ekiwi/iuhr/drawings/4digit.dxf

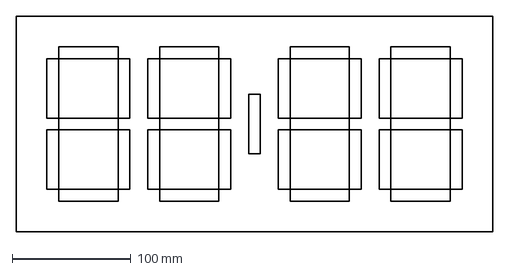
[picture p1: CAD file, 2013-12-15]
drawings/4digit.dxf
402.0 x 182.0 mm
