ekiwi/iuhr/drawings/5digit.dxf

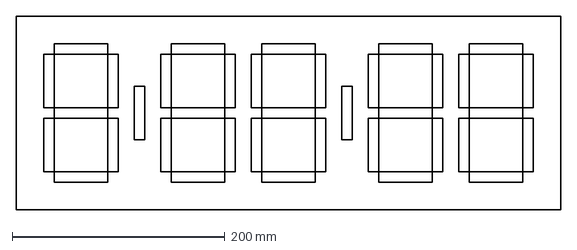
[picture p2: CAD file, 2013-12-15]
drawings/5digit.dxf
512.0 x 182.0 mm
