ekiwi/iuhr/pcbs/iuhr.brd

## EAGLE design pcbs/iuhr.brd (2014-12-14)

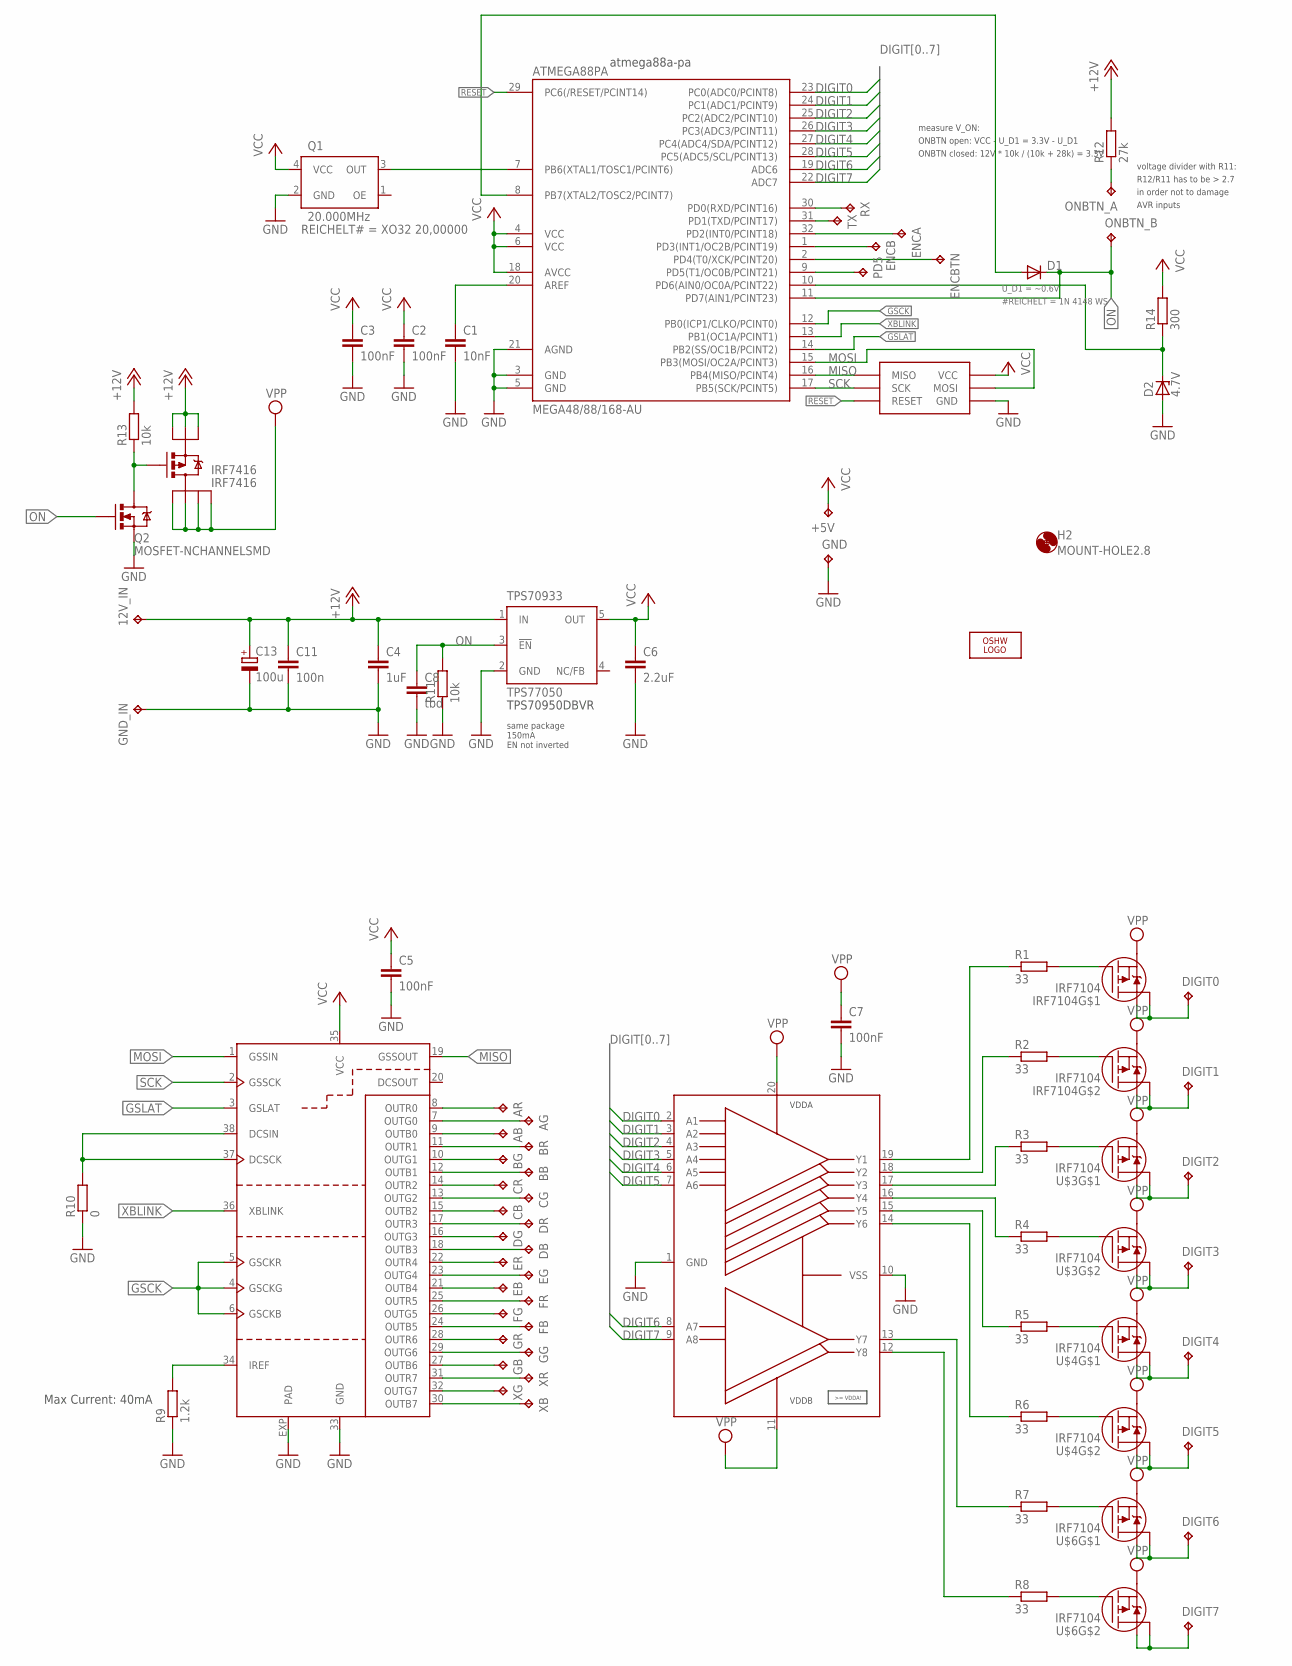
[picture p3: schematic iuhr.sch]

Parts:
12V_IN: TPTP20SQ; TP20SQ
+5V: TPTP15SQ; TP15SQ
AB: TPTP15SQ; TP15SQ
ADG3123: ADG3123BRUZ; TSSOP20
AG: TPTP15SQ; TP15SQ
AR: TPTP15SQ; TP15SQ
ATMEGA88PA: MEGA48/88/168-AU; TQFP32-08
BB: TPTP15SQ; TP15SQ
BG: TPTP15SQ; TP15SQ
BR: TPTP15SQ; TP15SQ
C1: 10nF; C0603
C2, C3, C5, C7: 100nF; C0603
C4: 1uF; C0805
C6: 2.2uF; C0805
C8: tbd; C0603
C11: 100n; C0603
C13: 100u; PANASONIC_E
CB: TPTP15SQ; TP15SQ
CG: TPTP15SQ; TP15SQ
CR: TPTP15SQ; TP15SQ
D1: DIODE-SOD323-R; SOD323-R
D2: 4.7V; SOT23
DB: TPTP15SQ; TP15SQ
DG: TPTP15SQ; TP15SQ
DIGIT0, DIGIT1, DIGIT2, DIGIT3, DIGIT4, DIGIT5, DIGIT6, DIGIT7: TPTP20SQ; TP20SQ
DR: TPTP15SQ; TP15SQ
EB: TPTP15SQ; TP15SQ
EG: TPTP15SQ; TP15SQ
ENCA: TPTP15SQ; TP15SQ
ENCB: TPTP15SQ; TP15SQ
ENCBTN: TPTP15SQ; TP15SQ
ER: TPTP15SQ; TP15SQ
FB: TPTP15SQ; TP15SQ
FG: TPTP15SQ; TP15SQ
FR: TPTP15SQ; TP15SQ
GB: TPTP15SQ; TP15SQ
GG: TPTP15SQ; TP15SQ
GND: TPTP15SQ; TP15SQ
GND_IN: TPTP20SQ; TP20SQ
GR: TPTP15SQ; TP15SQ
H2: MOUNT-HOLE2.8; 2,8
IRF7104: IRF7104; SO8-2
IRF7416: IRF7416; SO8-2
LOGO1: OSHW_LOGO_8MILX0200-NT; OSHW_8X200_NOTEXT
ONBTN_A: TPTP15SQ; TP15SQ
ONBTN_B: TPTP15SQ; TP15SQ
PD5: TPTP15SQ; TP15SQ
Q1: 20.000MHz; XO32
Q2: MOSFET-NCHANNELSMD; SOT23-3
R1, R2, R3, R4, R5, R6, R7, R8: 33; R0603
R9: 1.2k; R0603
R10: 0; R0603
R11, R13: 10k; R0603
R12: 27k; R0603
R14: 300; R0603
RX: TPTP15SQ; TP15SQ
TLC5951: TLC5951; HTSSOP38DAP
TPS70933: TPS77050; SOT23-DBV
TX: TPTP15SQ; TP15SQ
U$3, U$4, U$6: IRF7104; SO8-2
U$5: ISP_SPECIALS; ISP_RM2_00_STRAIGHT
XB: TPTP15SQ; TP15SQ
XG: TPTP15SQ; TP15SQ
XR: TPTP15SQ; TP15SQ

Connections:
+12V: 12V_IN.TP, C4.1, C11.1, C13.+, IRF7416.1 (S), IRF7416.2 (S1), IRF7416.3 (S2), R12.2, R13.2, TPS70933.1 (IN)
CLK_STM: ATMEGA88PA.7 (PB6(XTAL1/TOSC1/PCINT6)), Q1.3 (OUT)
DIGIT0: ADG3123.2 (A1), ATMEGA88PA.23 (PC0(ADC0/PCINT8))
DIGIT1: ADG3123.3 (A2), ATMEGA88PA.24 (PC1(ADC1/PCINT9))
DIGIT2: ADG3123.4 (A3), ATMEGA88PA.25 (PC2(ADC2/PCINT10))
DIGIT3: ADG3123.5 (A4), ATMEGA88PA.26 (PC3(ADC3/PCINT11))
DIGIT4: ADG3123.6 (A5), ATMEGA88PA.27 (PC4(ADC4/SDA/PCINT12))
DIGIT5: ADG3123.7 (A6), ATMEGA88PA.28 (PC5(ADC5/SCL/PCINT13))
DIGIT6: ADG3123.8 (A7), ATMEGA88PA.19 (ADC6)
DIGIT7: ADG3123.9 (A8), ATMEGA88PA.22 (ADC7)
GND: ADG3123.1 (GND), ADG3123.10 (VSS), ATMEGA88PA.3 (GND), ATMEGA88PA.5 (GND), ATMEGA88PA.21 (AGND), C1.2, C2.2, C3.2, C4.2, C5.2, C6.2, C7.2, C8.2, C11.2, C13.-, D2.1 (A), GND.TP, GND_IN.TP, Q1.2 (GND), Q2.2 (S), R9.1, R10.1, R11.1, TLC5951.33 (GND), TLC5951.EXP (PAD), TPS70933.2 (GND), U$5.VCC (GND)
GSCK: ATMEGA88PA.12 (PB0(ICP1/CLKO/PCINT0)), TLC5951.4 (GSCKG), TLC5951.5 (GSCKR), TLC5951.6 (GSCKB)
GSLAT: ATMEGA88PA.14 (PB2(SS/OC1B/PCINT2)), TLC5951.3 (GSLAT)
MISO: ATMEGA88PA.16 (PB4(MISO/PCINT4)), TLC5951.19 (GSSOUT), U$5.RESET (MISO)
MOSI: ATMEGA88PA.15 (PB3(MOSI/OC2A/PCINT3)), TLC5951.1 (GSSIN), U$5.MOSI
unnamed: AR.TP, TLC5951.8 (OUTR0)
unnamed: ATMEGA88PA.20 (AREF), C1.1
unnamed: AG.TP, TLC5951.7 (OUTG0)
unnamed: AB.TP, TLC5951.9 (OUTB0)
unnamed: BR.TP, TLC5951.11 (OUTR1)
unnamed: BG.TP, TLC5951.10 (OUTG1)
unnamed: ATMEGA88PA.30 (PD0(RXD/PCINT16)), RX.TP
unnamed: BB.TP, TLC5951.12 (OUTB1)
unnamed: CR.TP, TLC5951.14 (OUTR2)
unnamed: CG.TP, TLC5951.13 (OUTG2)
unnamed: CB.TP, TLC5951.15 (OUTB2)
unnamed: ATMEGA88PA.31 (PD1(TXD/PCINT17)), TX.TP
unnamed: DR.TP, TLC5951.17 (OUTR3)
unnamed: DG.TP, TLC5951.16 (OUTG3)
unnamed: DB.TP, TLC5951.18 (OUTB3)
unnamed: ER.TP, TLC5951.22 (OUTR4)
unnamed: EG.TP, TLC5951.23 (OUTG4)
unnamed: EB.TP, TLC5951.21 (OUTB4)
unnamed: FR.TP, TLC5951.25 (OUTR5)
unnamed: FG.TP, TLC5951.26 (OUTG5)
unnamed: ATMEGA88PA.32 (PD2(INT0/PCINT18)), ENCA.TP
unnamed: FB.TP, TLC5951.24 (OUTB5)
unnamed: GR.TP, TLC5951.28 (OUTR6)
unnamed: GG.TP, TLC5951.29 (OUTG6)
unnamed: GB.TP, TLC5951.27 (OUTB6)
unnamed: TLC5951.31 (OUTR7), XR.TP
unnamed: TLC5951.32 (OUTG7), XG.TP
unnamed: TLC5951.30 (OUTB7), XB.TP
unnamed: DIGIT0.TP, IRF7104.7 (D), IRF7104.8 (D)
unnamed: DIGIT1.TP, IRF7104.5 (D), IRF7104.6 (D)
unnamed: IRF7104.2 (G), R1.2
unnamed: IRF7104.4 (G), R2.2
unnamed: ADG3123.19 (Y1), R1.1
unnamed: DIGIT6.TP, U$6.7 (D), U$6.8 (D)
unnamed: DIGIT2.TP, U$3.7 (D), U$3.8 (D)
unnamed: DIGIT3.TP, U$3.5 (D), U$3.6 (D)
unnamed: R3.2, U$3.2 (G)
unnamed: R4.2, U$3.4 (G)
unnamed: ADG3123.17 (Y3), R3.1
unnamed: ADG3123.16 (Y4), R4.1
unnamed: DIGIT4.TP, U$4.7 (D), U$4.8 (D)
unnamed: DIGIT5.TP, U$4.5 (D), U$4.6 (D)
unnamed: R5.2, U$4.2 (G)
unnamed: R6.2, U$4.4 (G)
unnamed: ADG3123.15 (Y5), R5.1
unnamed: ADG3123.14 (Y6), R6.1
unnamed: ADG3123.18 (Y2), R2.1
unnamed: DIGIT7.TP, U$6.5 (D), U$6.6 (D)
unnamed: R7.2, U$6.2 (G)
unnamed: R8.2, U$6.4 (G)
unnamed: ADG3123.13 (Y7), R7.1
unnamed: ADG3123.12 (Y8), R8.1
unnamed: ATMEGA88PA.1 (PD3(INT1/OC2B/PCINT19)), ENCB.TP
unnamed: ATMEGA88PA.2 (PD4(T0/XCK/PCINT20)), ENCBTN.TP
unnamed: R9.2, TLC5951.34 (IREF)
unnamed: ATMEGA88PA.9 (PD5(T1/OC0B/PCINT21)), PD5.TP
unnamed: ATMEGA88PA.10 (PD6(AIN0/OC0A/PCINT22)), D2.3 (C), R14.1
unnamed: ATMEGA88PA.8 (PB7(XTAL2/TOSC2/PCINT7)), D1.A
unnamed: ONBTN_A.TP, R12.1
unnamed: R10.2, TLC5951.37 (DCSCK), TLC5951.38 (DCSIN)
unnamed: IRF7416.4 (G), Q2.3 (D), R13.1
ON: ATMEGA88PA.11 (PD7(AIN1/PCINT23)), C8.1, D1.C, ONBTN_B.TP, Q2.1 (G), R11.2, TPS70933.3 (!EN)
RESET: ATMEGA88PA.29 (PC6(/RESET/PCINT14)), U$5.MISO (RESET)
SCK: ATMEGA88PA.17 (PB5(SCK/PCINT5)), TLC5951.2 (GSSCK), U$5.SCK
VCC: +5V.TP, ATMEGA88PA.4 (VCC), ATMEGA88PA.6 (VCC), ATMEGA88PA.18 (AVCC), C2.1, C3.1, C5.1, C6.1, Q1.4 (VCC), R14.2, TLC5951.35 (VCC), TPS70933.5 (OUT), U$5.GND (VCC)
VPP: ADG3123.11 (VDDB), ADG3123.20 (VDDA), C7.1, IRF7104.1 (S), IRF7104.3 (S), IRF7416.5 (D3), IRF7416.6 (D2), IRF7416.7 (D1), IRF7416.8 (D), U$3.1 (S), U$3.3 (S), U$4.1 (S), U$4.3 (S), U$6.1 (S), U$6.3 (S)
XBLINK: ATMEGA88PA.13 (PB1(OC1A/PCINT1)), TLC5951.36 (XBLINK)

Notes on the sheet:
atmega88a-pa
Max Current: 40mA
TPS70950DBVR
same package 150mA EN not inverted
measure V_ON:
ONBTN open: VCC - U_D1 = 3.3V - U_D1
ONBTN closed: 12V * 10k / (10k + 28k) = 3.3V
voltage divider with R11:
R12/R11 has to be > 2.7
in order not to damage
AVR inputs

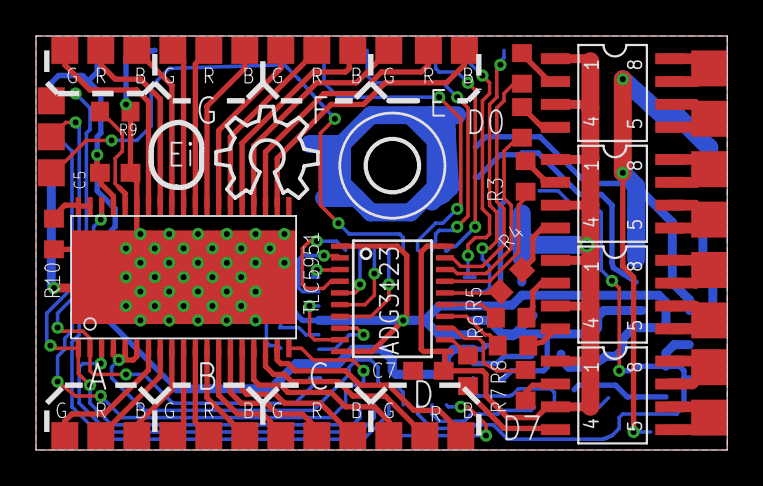
[picture p4: board iuhr.brd from above]

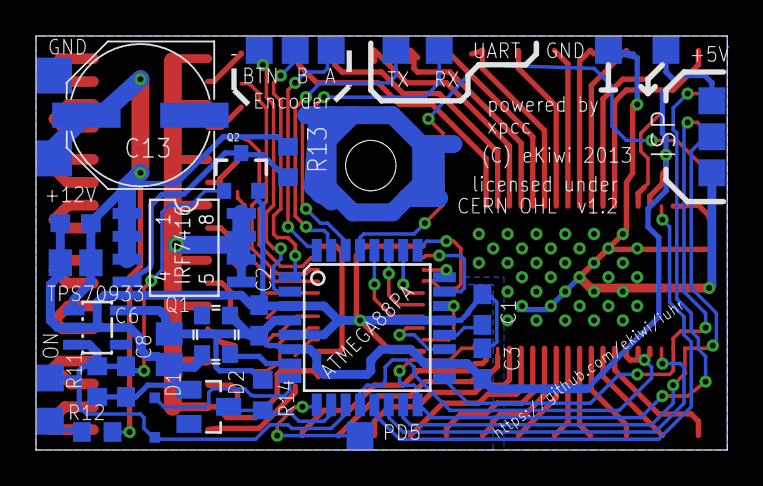
[picture p5: board iuhr.brd from below]

Board: 2 copper layers, 38.4 x 23.0 mm, 84 parts (31 on the bottom side), 82 nets.
