ekiwi/iuhr/(commit log)

2013-11-16 iUhr: add initial schematic
    [iuhr.sch]
2013-11-16 Started board layout
    [iuhr.brd, iuhr.sch]
2013-11-17 No Airwires. No unapproved DRC Errors.
    [iuhr.brd, iuhr.sch]
2013-11-17 Add ground plane and thermal vias.
    [iuhr.brd, iuhr.sch]
2013-11-17 Improved Silkscreen.
    [iuhr.brd, iuhr.sch]
2013-11-17 Break out unused pins
    [iuhr.brd, iuhr.sch]
2013-11-17 Further improve silkscreen.
    [iuhr.brd, iuhr.sch]
2013-11-17 VCC: 3.3V -> 5V; add cap for adg3123
    [iuhr.brd, iuhr.sch]
2013-11-17 Power On: add cap and series resistor for button.
    [iuhr.brd, iuhr.sch]
2013-11-17 Add p-channel mosfet to be able to shut off 12V part.
    TODO: find space on board
    [iuhr.brd, iuhr.sch]
2013-11-18 correct power-on button and add detection
    ToDo: - reassign DIGIT6
    - layout for this commit
    [iuhr.brd, iuhr.sch]
2013-11-18 Can now use "ON" Switch to turn board off
    [iuhr.brd, iuhr.sch]
2013-11-19 Swap functionality of PB7 and PD5
    [iuhr.brd, iuhr.sch]
2013-11-19 Improved GND connectivity
    [iuhr.brd, iuhr.sch]
2013-11-19 Add GND and +5V breakout pads.
    [iuhr.brd, iuhr.sch]
2013-11-19 Improve silkscreen.
    [iuhr.brd]
2013-11-20 Separate logic and power ground.
    [iuhr.brd]
2013-11-20 Small silk screen fixes.
    [iuhr.brd]
2013-12-15 Drawings: add dxf
    [4digit.dxf, 5digit.dxf]
2013-12-17 Software: staying alive and Uart
    [project.cfg]
2013-12-20 some TLC code
    [project.cfg]
2014-04-16 Use different programmer
    [project.cfg]
2014-04-16 TLC: fix incorrect shift
    [tlc.hpp]
2014-12-14 Tlc: port to latest xpcc
    [project.cfg]
2014-12-14 Main: leds are glowing!!
2014-12-14 Pcb: digital logic needs to run on 3.3V
    The osicallator only works with 3.3V
    (which I realized one year after designing this...)
    thus we will run the whole logic with 3.3V
    which works for all chips except for the
    atmega which is now a little bit overclocked.
    It still seems to work, but is not recommended
    for production.
    [iuhr.brd, iuhr.sch]
2014-12-15 Latest xpcc develop
    There is still a patch for
    Spi missing though.
