ekiwi/iuhr/(notices)

Notices in the files:
pcbs/iuhr.brd:
licensed under
CERN OHL v1.2
parts and their libraries:
irf-2: Copyright & License
This library is licensed under the General Public License, Version 2.
More Information about the General Public License is available at http://www.gnu.org/copyleft/gpl.html.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
